sleekmanuel/Mmuo/Mmuo.kicad_pcb

## KiCad design Mmuo.kicad_pcb (2025-12-22)

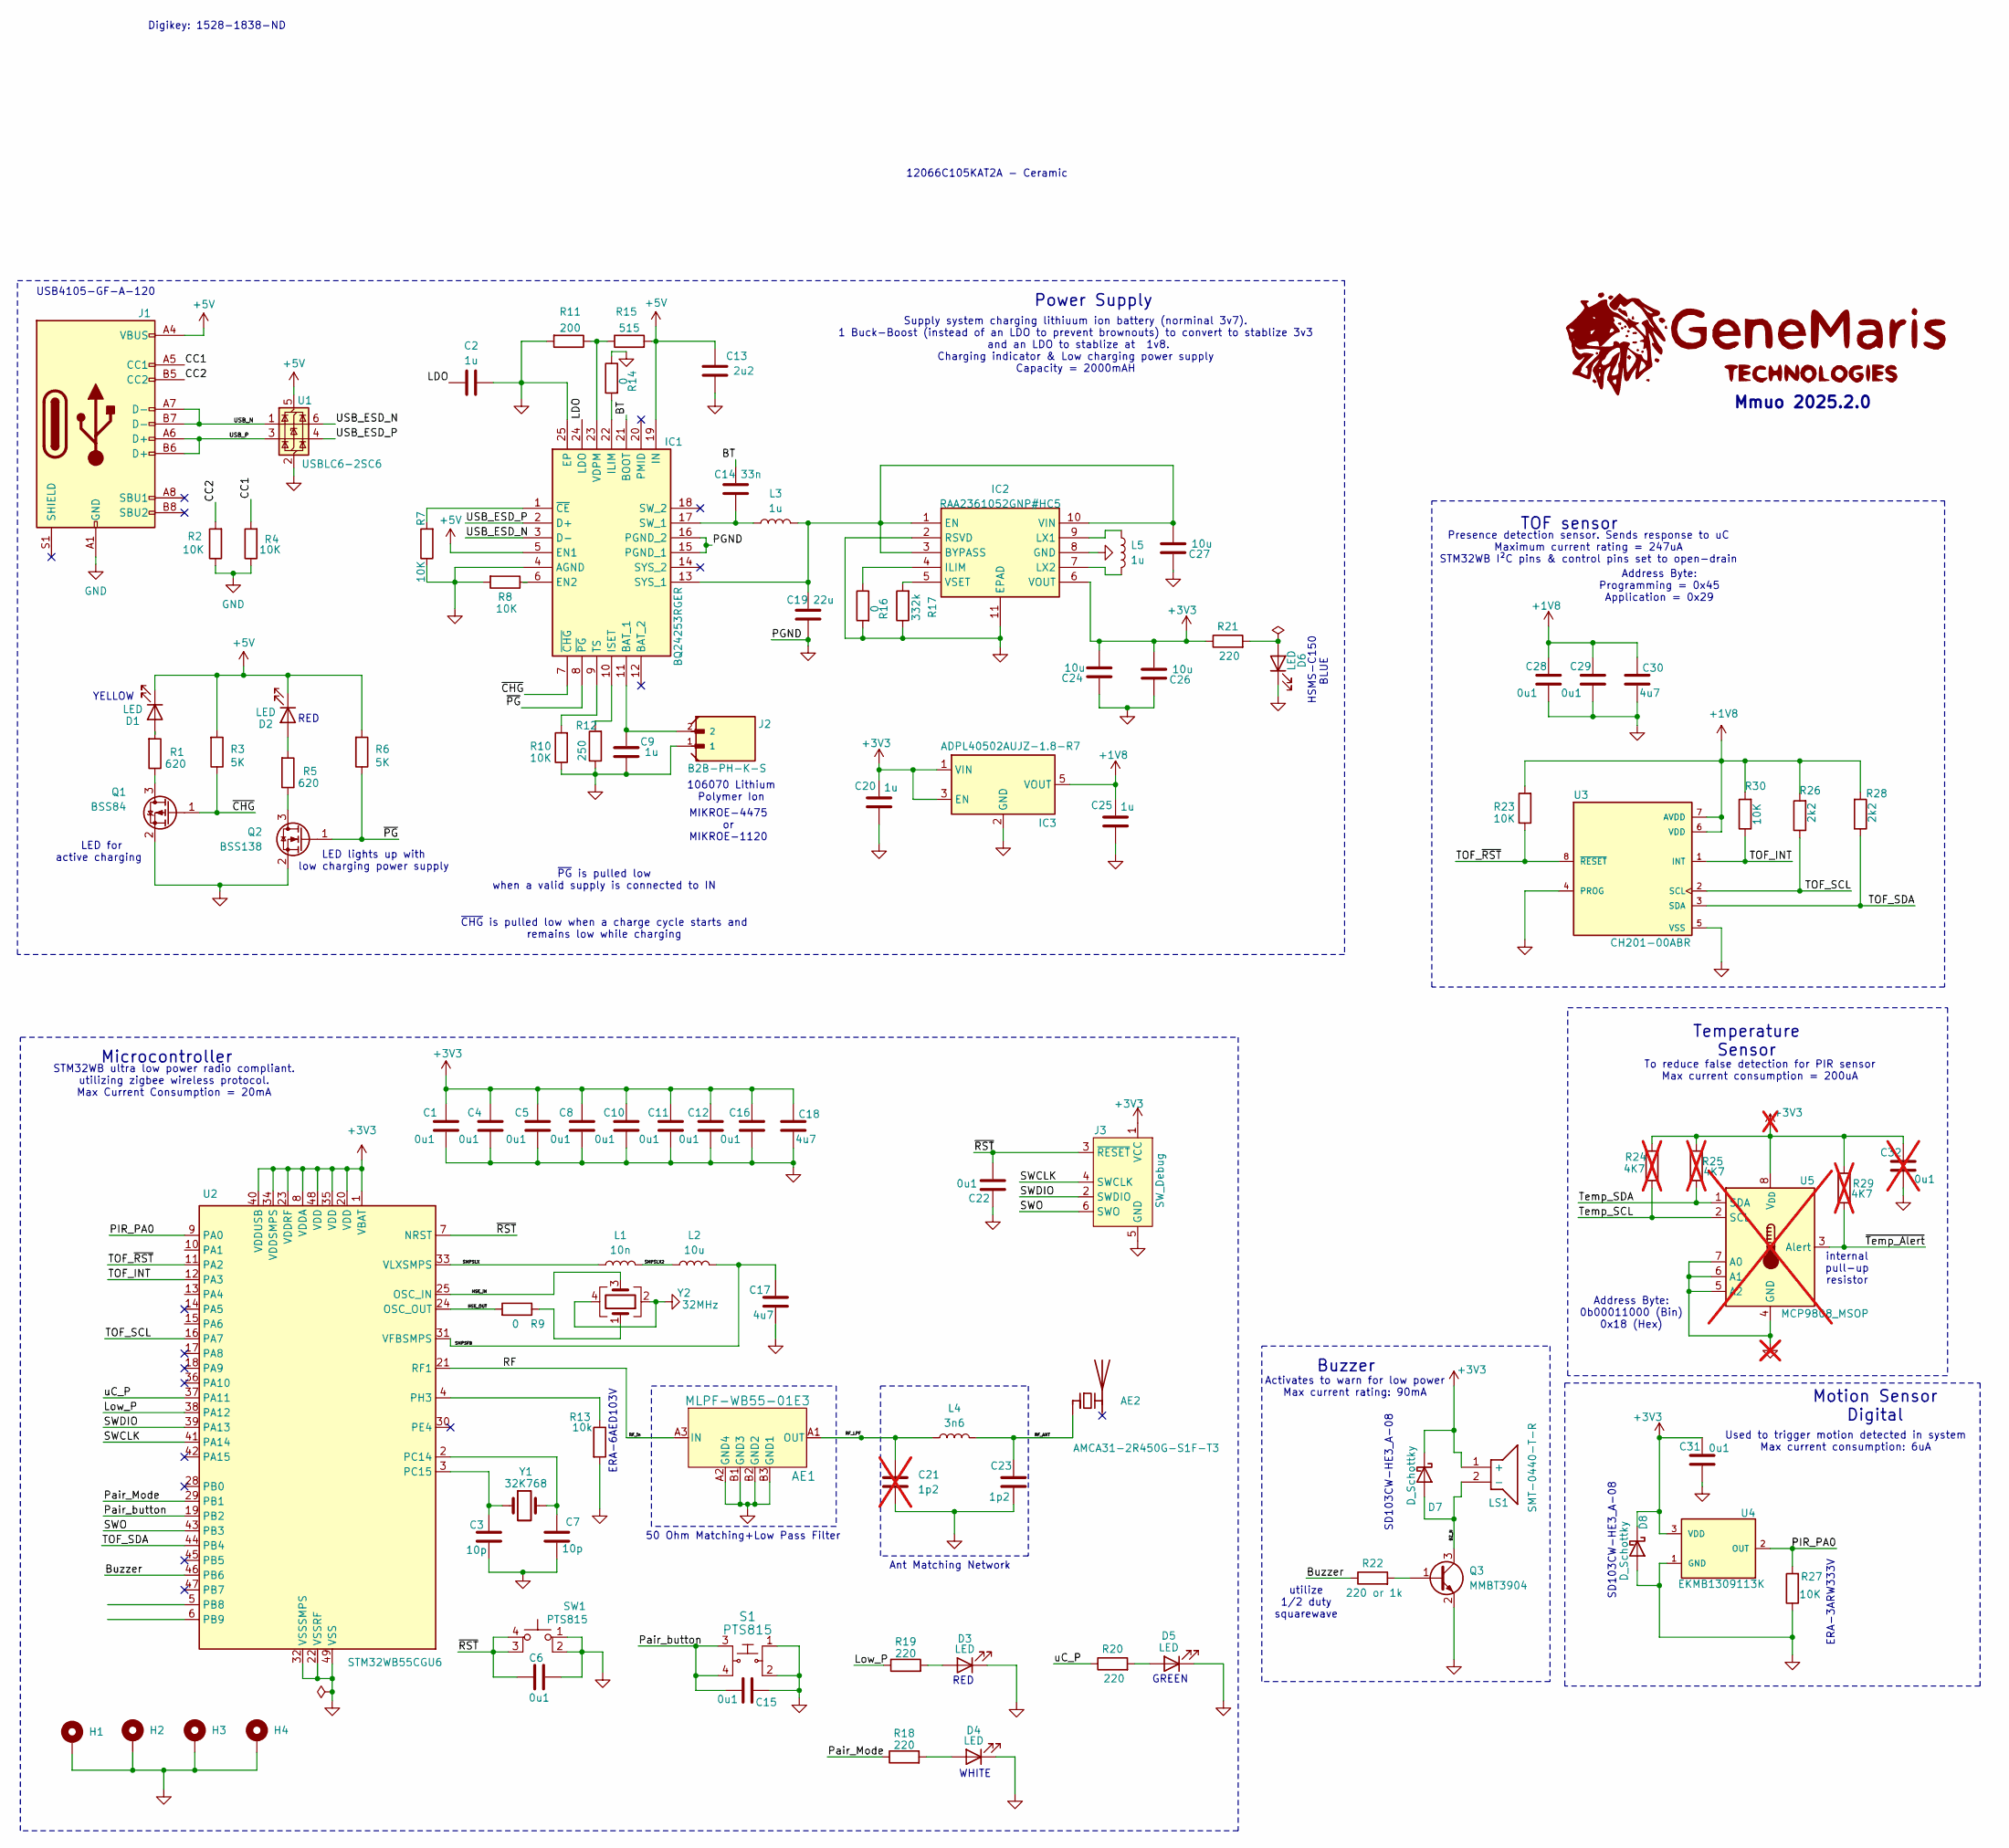
[picture p1: schematic Mmuo.kicad_sch]

Parts:
AE1: MLPF-WB55-01E3; MLPF-WB55-01E3_STM
AE2: AMCA31-2R450G-S1F-T3; ANTC3216X140N
C1, C4, C5, C8, C10, C11, C12, C16, C28, C29: 0u1; C_0603_1608Metric_Pad1.08x0.95mm_HandSolder
C2, C9, C20, C25: 1u; C_0603_1608Metric_Pad1.08x0.95mm_HandSolder
C3, C7: 10p; C_0603_1608Metric_Pad1.08x0.95mm_HandSolder
C6: 0u1; C_0603_1608Metric_Pad1.08x0.95mm_HandSolder; JLCPCB Part # C149621
C13: 2u2; C_0603_1608Metric_Pad1.08x0.95mm_HandSolder
C14: 33n; C_0603_1608Metric_Pad1.08x0.95mm_HandSolder
C15, C22, C31: 0u1; C_0603_1608Metric_Pad1.08x0.95mm_HandSolder; Manufacturer_Part_Number 06036C104JAT2A
C17, C18, C30: 4u7; C_0805_2012Metric_Pad1.18x1.45mm_HandSolder
C19: 22u; C_0603_1608Metric_Pad1.08x0.95mm_HandSolder
C21: 1p2; C_0402_1005Metric; not fitted
C23: 1p2; C_0402_1005Metric
C24, C26, C27: 10u; C_0603_1608Metric_Pad1.08x0.95mm_HandSolder
C32: 0u1; C_0603_1608Metric_Pad1.08x0.95mm_HandSolder; Manufacturer_Part_Number 06036C104JAT2A; not fitted
D1, D2, D5, D6: LED; LED_0805_2012Metric_Pad1.15x1.40mm_HandSolder; Manufacturer_Part_Number HSMS-C150; JLCPCB Part# C375580
D3, D4: LED; LED_0805_2012Metric_Pad1.15x1.40mm_HandSolder; Manufacturer_Part_Number HSMD-C150; JLCPCB Part# C62128
D7, D8: D_Schottky; D_SOD-123; Manufacturer_Part_Number SD103CW-HE3_A-08; JLCPCB Part# C2102
H1, H2, H3, H4: MountingHole_Pad; MountingHole_3.5mm_Pad_TopBottom
IC1: BQ24253RGER; QFN50P400X400X100-25N-D; Mouser Part Number 595-BQ24253RGER
IC2: RAA2361052GNP#HC5; SON50P250X250X90-11N-D; Manufacturer_Part_Number RAA2361052GNP#HC5
IC3: ADPL40502AUJZ-1.8-R7; SOT95P280X100-5N; Mouser Part Number 584-ADPL40502AUJZ18R
J1: USB_C_Receptacle_USB2.0_16P; USB_C_Receptacle_GCT_USB4105-xx-A_16P_TopMnt_Horizontal
J2: B2B-PH-K-S; JST_B2B-PH-K-S
J3: SW_Debug; Tag-Connect_TC2030-IDC-FP_2x03_P1.27mm_Vertical
L1: 10n; L_0805_2012Metric_Pad1.05x1.20mm_HandSolder
L2: 10u; L_0805_2012Metric_Pad1.05x1.20mm_HandSolder
L3, L5: 1u; L_0805_2012Metric_Pad1.05x1.20mm_HandSolder
L4: 3n6; L_0402_1005Metric
LS1: SMT-0440-T-R; SMT0440TR; Mouser Part Number 665-SMT-0440-T-R
Q1: BSS84; SOT-23
Q2: BSS138; SOT-23
Q3: MMBT3904; SOT-23
R1, R5: 620; R_0603_1608Metric_Pad0.98x0.95mm_HandSolder; Manufacturer_Part_Number CRCW060310K0FKEI
R2, R4, R7, R8, R27: 10K; R_0805_2012Metric_Pad1.20x1.40mm_HandSolder; Manufacturer_Part_Number CRCW060310K0FKEI
R3, R6: 5K; R_0805_2012Metric_Pad1.20x1.40mm_HandSolder; Manufacturer_Part_Number CRCW060310K0FKEI
R9, R14, R16: 0; R_0603_1608Metric_Pad0.98x0.95mm_HandSolder
R10, R23, R30: 10K; R_0603_1608Metric_Pad0.98x0.95mm_HandSolder; Manufacturer_Part_Number CRCW060310K0FKEI
R11: 200; R_0603_1608Metric_Pad0.98x0.95mm_HandSolder; Manufacturer_Part_Number CRCW060310K0FKEI
R12: 250; R_0603_1608Metric_Pad0.98x0.95mm_HandSolder; Manufacturer_Part_Number CRCW060310K0FKEI
R13: 10k; R_0805_2012Metric_Pad1.20x1.40mm_HandSolder; JLCPCB Part # C3016734
R15: 515; R_0603_1608Metric_Pad0.98x0.95mm_HandSolder; Manufacturer_Part_Number CRCW060310K0FKEI
R17: 332k; R_0603_1608Metric_Pad0.98x0.95mm_HandSolder; Manufacturer_Part_Number CRCW060310K0FKEI
R18, R19, R20, R21: 220; R_0603_1608Metric_Pad0.98x0.95mm_HandSolder; Manufacturer_Part_Number CRCW060310K0FKEI
R22: 220 or 1k; R_0603_1608Metric_Pad0.98x0.95mm_HandSolder; Manufacturer_Part_Number CRCW060310K0FKEI
R24, R25: 4K7; R_0805_2012Metric_Pad1.20x1.40mm_HandSolder; Manufacturer_Part_Number CRCW060310K0FKEI; not fitted
R26, R28: 2k2; R_0603_1608Metric_Pad0.98x0.95mm_HandSolder; Manufacturer_Part_Number CRCW060310K0FKEI
R29: 4K7; R_0603_1608Metric_Pad0.98x0.95mm_HandSolder; Manufacturer_Part_Number CRCW060310K0FKEI; not fitted
S1: PTS815; PTS815SJK250SMTRLFS; MPN TL3315NF160Q; Digi-Key_PN EG4621CT-ND
SW1: PTS815; PTS815SJK250SMTRLFS; JLCPCB Part # C411883
U1: USBLC6-2SC6; SOT-23-6
U2: STM32WB55CGU6; QFN-48-1EP_7x7mm_P0.5mm_EP5.6x5.6mm
U3: CH201-00ABR; XDCR_CH201-00ABR; PARTREV 1.1; DigiKey_Part_Number 1428-CH201-00ABRCT-ND
U4: EKMB1309113K; XDCR_EKMB; Manufacturer_Part_Number EKMB1309113K
U5: MCP9808_MSOP; MSOP-8_3x3mm_P0.65mm; not fitted
Y1: 32K768; Crystal_SMD_2012-2Pin_2.0x1.2mm_HandSoldering
Y2: 32MHz; Crystal_SMD_2016-4Pin_2.0x1.6mm

Connections:
+1V8: C25.1, C28.1, C29.1, C30.1, IC3.5 (VOUT), R23.2, R26.2, R28.2, R30.2, U3.6 (VDD), U3.7 (AVDD)
+3V3: C1.1, C4.1, C5.1, C8.1, C10.1, C11.1, C12.1, C16.1, C18.1, C20.1, C24.1, C26.1, C31.1, C32.1, D7.1 (K), D8.1 (K), IC2.6 (VOUT), IC3.1 (VIN), IC3.3 (EN), J3.1 (VCC), LS1.1 (+), R21.1, R24.2, R25.2, R29.2, U2.1 (VBAT), U2.8 (VDDA), U2.20 (VDD), U2.23 (VDDRF), U2.34 (VDDSMPS), U2.35 (VDD), U2.40 (VDDUSB), U2.48 (VDD), U4.3 (VDD), U5.8 (V_{DD})
+5V: C13.1, D1.1 (K), D2.1 (K), IC1.5 (EN1), IC1.19 (IN), J1.A4 (VBUS), J1.A9 (VBUS), J1.B4 (VBUS), J1.B9 (VBUS), R3.2, R6.2, R15.2, U1.5 (VBUS)
/BT: C14.1, IC1.21 (BOOT)
/BZ_N: D7.2 (A), LS1.2 (-), Q3.3 (C)
/Buzzer: R22.1, U2.46 (PB6)
/CC1: J1.A5 (CC1), R4.2
/CC2: J1.B5 (CC2), R2.2
/HSE_IN: U2.25 (OSC_IN), Y2.3
/HSE_OUT: R9.2, U2.24 (OSC_OUT)
/LDO: C2.1, IC1.24 (LDO)
/Low_P: R19.1, U2.38 (PA12)
/PIR_PA0: R27.2, U2.9 (PA0), U4.2 (OUT)
/Pair_Mode: R18.1, U2.29 (PB1)
/Pair_button: C15.2, S1.3, S1.4, U2.19 (PB2)
/RF: AE1.A3 (IN), U2.21 (RF1)
/RF_ANT: AE2.1 (FEED), C23.1, L4.1
/RF_LPF: AE1.A1 (OUT), C21.1, L4.2
/SMPSFB: C17.1, L2.1, U2.31 (VFBSMPS)
/SMPSLX: L1.2, U2.33 (VLXSMPS)
/SMPSLX2: L1.1, L2.2
/SWCLK: J3.4 (SWCLK), U2.41 (PA14)
/SWDIO: J3.2 (SWDIO), U2.39 (PA13)
/SWO: J3.6 (SWO), U2.43 (PB3)
/TOF_INT: R30.1, U2.12 (PA3), U3.1 (INT)
/TOF_SCL: R26.1, U2.16 (PA7), U3.2 (SCL)
/TOF_SDA: R28.1, U2.44 (PB4), U3.3 (SDA)
/TOF_~RST: R23.1, U2.11 (PA2), U3.8 (~RESET)
/USB_ESD_N: IC1.3 (D-), U1.6 (I/O1)
/USB_ESD_P: IC1.2 (D+), U1.4 (I/O2)
/USB_N: J1.A7 (D-), J1.B7 (D-), U1.1 (I/O1)
/USB_P: J1.A6 (D+), J1.B6 (D+), U1.3 (I/O2)
/uC_P: R20.1, U2.37 (PA11)
/~CHG: IC1.7 (~CHG), Q1.1 (G), R3.1
/~PG: IC1.8 (~PG), Q2.1 (G), R6.1
/~RST: C6.2, C22.2, J3.3 (~RESET), SW1.3 (K), SW1.4 (A), U2.7 (NRST)
GND: AE1.A2 (GND4), AE1.B1 (GND3), AE1.B2 (GND2), AE1.B3 (GND1), C1.2, C2.2, C3.2, C4.2, C5.2, C6.1, C7.2, C8.2, C9.2, C10.2, C11.2, C12.2, C13.2, C15.1, C16.2, C17.2, C18.2, C19.2, C20.2, C21.2, C22.1, C23.2, C24.2, C25.2, C26.2, C27.2, C28.2, C29.2, C30.2, C31.2, C32.2, D3.1 (K), D4.1 (K), D5.1 (K), D6.1 (K), D8.2 (A), H1.1, H2.1, H3.1, H4.1, IC1.4 (AGND), IC1.15 (PGND_1), IC1.16 (PGND_2), IC1.25 (EP), IC2.2 (RSVD), IC2.8 (GND), IC2.11 (EPAD), IC3.2 (GND), J1.A1 (GND), J1.A12 (GND), J1.B1 (GND), J1.B12 (GND), J2.1, J3.5 (GND), Q1.2 (S), Q2.2 (S), Q3.2 (E), R2.1, R4.1, R7.1, R8.2, R10.1, R11.2, R12.1, R13.2, R14.1, R16.2, R17.1, R27.1, S1.1, S1.2, SW1.1, SW1.2, U1.2 (GND), U2.22 (VSSRF), U2.32 (VSSSMPS), U2.49 (VSS), U3.4 (PROG), U3.5 (VSS), U4.1 (GND), U5.4 (GND), U5.5 (A2), U5.6 (A1), U5.7 (A0), Y2.2, Y2.4
unnamed: D1.2 (A), R1.2
unnamed: D2.2 (A), R5.2
unnamed: D3.2 (A), R19.2
unnamed: D4.2 (A), R18.2
unnamed: D5.2 (A), R20.2
unnamed: D6.2 (A), R21.2
unnamed: C9.1, IC1.11 (BAT_1), J2.2
unnamed: IC1.6 (EN2), R8.1
unnamed: IC1.22 (ILIM), R14.2
unnamed: IC1.10 (ISET), R12.2
unnamed: C14.2, IC1.17 (SW_1), L3.1
unnamed: C19.1, C27.1, IC1.13 (SYS_1), IC2.1 (EN), IC2.3 (BYPASS), IC2.10 (VIN), L3.2
unnamed: IC1.9 (TS), R10.2
unnamed: IC1.23 (VDPM), R11.1, R15.1
unnamed: IC1.1 (~CE), R7.2
unnamed: IC2.4 (ILIM), R16.1
unnamed: IC2.9 (LX1), L5.1
unnamed: IC2.7 (LX2), L5.2
unnamed: IC2.5 (VSET), R17.2
unnamed: Q1.3 (D), R1.1
unnamed: Q2.3 (D), R5.1
unnamed: Q3.1 (B), R22.2
unnamed: R9.1, Y2.1
unnamed: R24.1, U5.2 (SCL)
unnamed: R25.1, U5.1 (SDA)
unnamed: R29.1, U5.3 (Alert)
unnamed: C7.1, U2.2 (PC14), Y1.2
unnamed: C3.1, U2.3 (PC15), Y1.1
unnamed: R13.1, U2.4 (PH3)

Notes on the sheet:
RED
Buzzer
YELLOW
Address Byte: 0b00011000 (Bin) 0x18 (Hex)
HSMS-C150
12066C105KAT2A - Ceramic
Motion Sensor Digital
Supply system charging lithiuum ion battery (norminal 3v7). 1 Buck-Boost (instead of an LDO to prevent brownouts) to convert to stablize 3v3 and an LDO to stablize at 1v8. Charging indicator & Low charging power supply Capacity = 2000mAH
Temperature Sensor
Microcontroller
LED lights up with low charging power supply
${TITLE} ${REVISION}
MIKROE-4475 or MIKROE-1120
LED for active charging
GREEN
SD103CW-HE3_A-08
utilize 1/2 duty squarewave
Power Supply
106070 Lithium Polymer Ion
ERA-3ARW333V
Used to trigger motion detected in system Max current consumption: 6uA
STM32WB ultra low power radio compliant. utilizing zigbee wireless protocol. Max Current Consumption = 20mA
Activates to warn for low power Max current rating: 90mA
50 Ohm Matching+Low Pass Filter
Presence detection sensor. Sends response to uC Maximum current rating = 247uA STM32WB I²C pins & control pins set to open-drain
To reduce false detection for PIR sensor Max current consumption = 200uA
~{PG} is pulled low when a valid supply is connected to IN
Ant Matching Network
BLUE
~{CHG} is pulled low when a charge cycle starts and remains low while charging
TOF sensor
internal pull-up resistor
ERA-6AED103V
WHITE
USB4105-GF-A-120
Address Byte: Programming = 0x45 Application = 0x29
Digikey: 1528-1838-ND

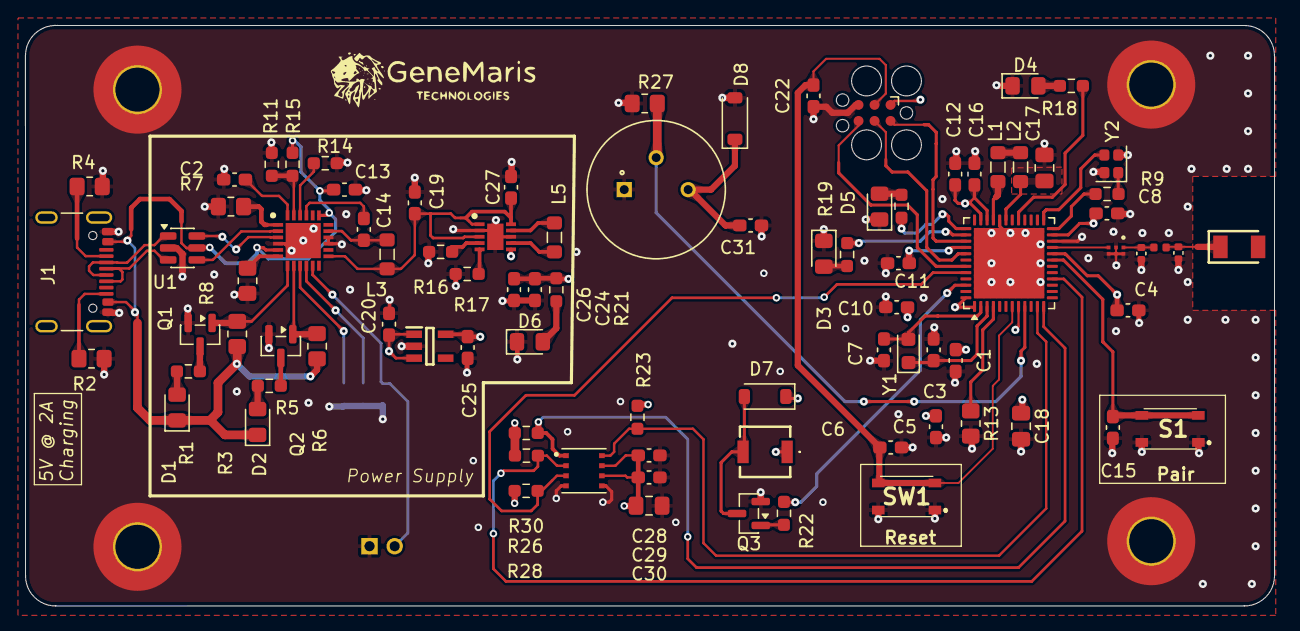
[picture p2: board Mmuo.kicad_pcb from above]

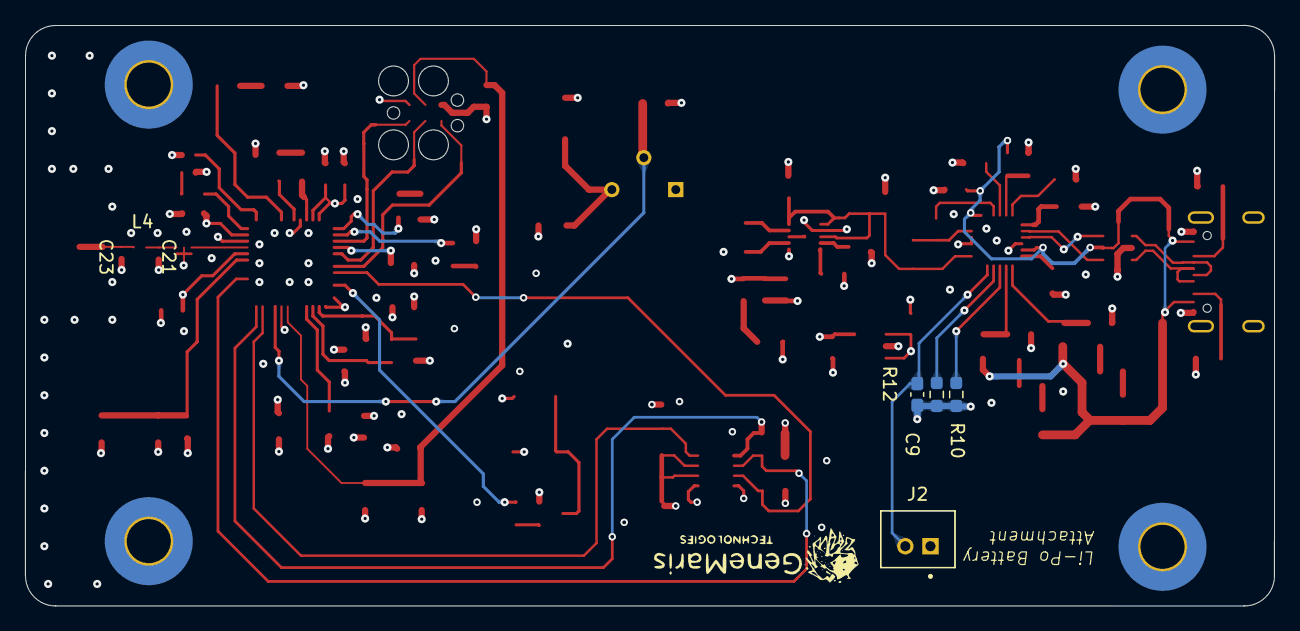
[picture p3: board Mmuo.kicad_pcb from below]

Board: 4 copper layers, 99.3 x 46.2 mm, 95 parts (4 on the bottom side), 63 nets.
