sleekmanuel/Mmuo/(commit log)

2025-11-04 Schematics Verifcation
    [Mmuo.kicad_pcb, Mmuo.kicad_sch]
2025-11-19 replacing 3v3 LDO to boost-buck converter
    [Mmuo.kicad_pcb, Mmuo.kicad_sch]
2025-11-19 replaced LDO and rough cut of pcb
    [Mmuo.kicad_sch]
2025-11-20 Layout and initial routing
    [Mmuo.kicad_pcb, Mmuo.kicad_sch]
2025-12-12 PCB design and full verification
    [Mmuo.kicad_pcb, Mmuo.kicad_sch]
2025-12-18 min via diameter change to 0.15mm
    [Mmuo.kicad_pcb]
2025-12-19 V2.0: using a TOF sensor instead of a mmWave sensor
    [Mmuo.kicad_pcb, Mmuo.kicad_sch]
